wifixcort/moto_location/Readme.md

Moto Location

This sketch use FONA 808 and sparkfun SAMD21 mini to locate through GPS my motorcicle

It use io.adafruit.com platform(MQTT)
