wifixcort/moto_location/motoloc.pdf

UNIVERSIDAD DE COSTA RICA, JULIO 2016 | 1

# Sistema de GPS en Tiempo Real ”MotoLoc”

Ricardo Mena C.

Resumen—Sistema GPS que permite la localizacion de una motocicleta mediante la FONA 808 utilizando el proto ´ | colo MQTT

Index Terms—GPS, FONA808, motoloc

✦

### 1. INTRODUCCION´

E
STE proyecto atiende a una necesidad puntual, la cual es la localizacion mediante GPS de un objeto, en este caso ´ una motocicleta. Esto ofrece cierta seguridad de recuperacion en caso de robo, como ya muchas empresas lo ofrecen, ´
pero ademas que el costo econ ´ | omico de mantenimiento sea ´
mínimo.
Otro inconveniente de los servicios existentes ademas de ´ su elevado costo, es que ofrecen muchos servicios dentro de
un paquete unico, no solamente la localizaci ´ | on. Por lo que ´
no resultaba conveniente adquirir un servicio de terceros.

### 2. COMUNICACION´

Se penso poder tener actualizaciones constantes de la ´
posicion, por lo que se deb ´ | ía contar con una plataforma
con la mayor area de covertura posible dentro del territo- ´ rio nacional, debido a este hecho la primera y mas obvia ´
opcion era la plataforma celular existente, por esta raz ´ | | on se ´
utilizo la ´ | FONA808 dado que es un transmisor celular con
las mismas capacidades que cualquier otro telefono celular. ´ En cuanto a costos independientmente del operador celular, se podían enviar mensajes de texto¹SMS con la informacion, por cada mensaje se eleva el costo, por lo que la ´ mejor opcion deb ´ ía ser utilizar GPRS y de esta forma enviar los mensajes mediante internet; siendo necesario la eleccion´ de un protocolo de comunicacion, as ´ í como una plataforma web para publicar los datos.

### 2.1. Protocolo de Comunicacion´

La seleccion del protocolo de comunicaci ´ | on deb ´ | ía cum-
plir dos aspectos: Verificacion de entrega y tama ´ | | no de ˜
tramos de datos muy pequena, para que se consumiera la ˜ mínima cantidad de datos de GPRS posibles.
Dadas las razones antes mencionandas se selecciono el ´ protocolo MQTT como protocolo de comunicacion. El cual ´ es un protocolo ligero de mesajería, disenado para dispo- ˜ sitivos con restriccion de ancho de banda. Los principios ´ de diseno son para minimizar el ancho de banda de la red ˜ y los requisitos de recursos del dispositivo a la vez que el intento de asegurar la fiabilidad y cierto grado de garantía de entrega [MQTT, 1999].
1. Short Message Service

### 2.2. Plataforma Web

Existen varias plataformas web que implementan 2brokers de MQTT así como tambien puede crearse un servi- ´ cio propio en cualquier servidor. El principal inconveniente de la mayoría de las plataformas era que no disponía de una interfaz web simple para construir y modificar el proyecto. Dada la naturaleza del prototipo se esperanban muchos cambios, por lo que se elijió io.adafruit.com.
Esta plataforma se encuentra actualmente en fase BETA por lo que presenta varias limitaciones tanto de espacio como de confiabilidad, pero lo que se desea verificar es la usabilidad y utilidad del prototipo. Esto se debe a que la plataforma puede cambiarse en cualquier momento, para tener un servicio mas confiable y con menos limitaciones ´ como la cantidad de datos que pueden almacenarse.

### 3. CONSTITUCION´

Para realizar el sistema fue necesario:

Microcontrolador: SAMD21 de sparkfun Transmisor GPRS/GPS: FONA 808
StepDown: Etapa de reduccion de tensi ´ | on´
Sensor de Vibracion: Aceler ´ | ometro ADXL335 ´
Cables de silicon´

### 3.1. Microcontrolador

Para este diseno se utiliz ˜ | o el sparkfun SAMD21 deve- ´
lopment board mini, ya que su tamano f ˜ | ísico y capacidades
de espacio en memoria eran optimos, tanto para albergar el ´ proyecto como para servir de ”prevista”, en caso de futuras mejoras. Este pequeno microcontrolador es un chip ARM de ˜ 12bit lo que permite un mayor muestreo y por consecuencia mayor presicion. ´
Este alberga todos los algorítmos logicos del sistema por ´ lo que sus funciones son las de mantener la conectividad con la red celular y en caso de una perdida realizar la reco- ´ nexion, si esto no resultase efectivo debe hacer un reinicio ´ automatico de la FONA808. Realizar mediciones del GPS, ´ nivel de batería y vibraciones ocurridas.
Anteriormente al SAMD21 se utilizo un ”Trinket pro”, ´ el cual es un AVR de 8 bits, el espacio de este pequenõ
2. Servidor intermediario que publica los mensajes recibidos microcontrolador apenas permitía gestionar el control de la
FONA808 y las lecturas de GPS. Por esta razon se pens ´ | o en ´
una mejor plataforma de hardware como el SAMD21 ya que era conveniente crear un diseno que permitiera posteriores ˜ modificaciones, como las que se realizaron algun tiempo ´ despues de a ´ nadir un sensor para medir vibraciones, entre ˜ otros cambios planeados.

### 3.2. Transmisor GPRS/GPS

Para este prototipo se eligio la FONA808 de Adafruit ´
por una razon coincidente con la elecci ´ | on del SAMD21, su ´
tamano como primer punto. ˜
Aunque esta tarjeta es solamente transmisor en las bandas celulares y para que sea funcional requiere de un microcontrolador, tiene como característica la incorporacion´
de un GPS, ademas de un cargador de bater ´ | ía. Por lo que
solucionaba el evitar el gasto en un transmisor celular y por aparte un GPS, que no solo incluye un costo economico en ´
la ecuacion, sino que tambi ´ | en beneficia en una reducci ´ | on de ´
espacio.

### 3.3. StepDown

El SAMD21 es un microcontrolador de tecnología CMOS
por lo que su tension de operaci ´ | on es de tan solo 3.3v, ´
aunque como es una placa de desarrollo tiene un regulador de 5v para que pueda conectarse sin problemas a una computadora para programarlo, aun as ´ í el sistema electrico ´ de las motocicletas trabajan a una tension de 12v por lo que ´ no puede utilizarse de forma directa para el proyecto.
Por esta razon es necesario una etapa de reducci ´ | on de ´
tension para que la motocicleta alimente de forma constante ´ el proyecto y cargue una batería de respaldo de 2200mA con
una duracion aproximada de 3 d ´ | ías con carga, en caso de
fallo o desconeccion malintencionada de la bater ´ | ía principal.

### 3.4. Sensor de vibracion´

Al prototipo se le anadi ˜ | o un sensor de vibraci ´ | on o m ´ | as´
bien un acelerometro utilizado como sensor de vibraci ´ | on´
luego de haber tenido un percanse mientras se dejo la ´ motocicleta en un parqueo, el cual no informo debidamente ´ tal hecho.
Se utilizo un aceler ´ | ometro ADXL335 el cual es un sensor ´
analogico [ ´ | IteadStudio, 2011]; solo se lee uno de los tres
canales ya que cualquier vibracion debe afectar en los tres ´ ejes.
Las primeras pruebas para utilzar el acelerometro como ´
un sensor de vibracion fueron simplmente por inspecci ´ | on. ´
Imprimir en el puerto serial de Arduino IDE los datos en crudo del sensor como se aprecia en la figura 1;
Se aislo una de las perturbaciones para facilitar la inspec- ´
cion de la se ´ | nal en cuesti ˜ | on como se aprecia en la figura ´ | 2.
Durante el proceso de investifgacion se not ´ | o que al golpear ´
la motocicleta los datos por razon obvia iban a variar en un ´
lapso muy pequeno de tiempo con una dispersi ˜ | on de los ´
datos bastatante pronunciada, esto dio paso a pensar inmediatamente en la desviacion est ´ andar de un promedio de ´ datos. Una forma muy simple de poder medir la vibracion´ y tener cierta idea de su intensidad.

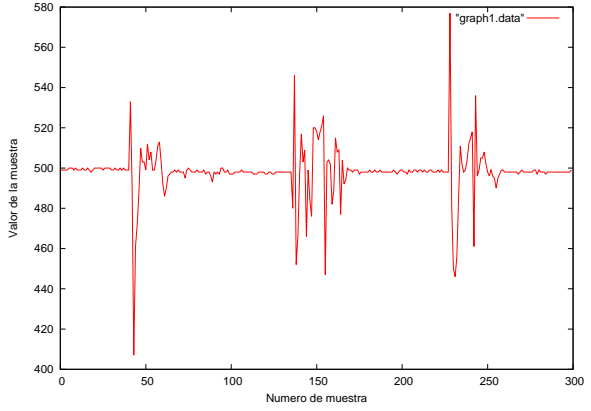
[picture p1: figure]
Valor de la muestra; Numero de muestra; "graph1.data"

Figura 1. Datos del sensor ADXL335

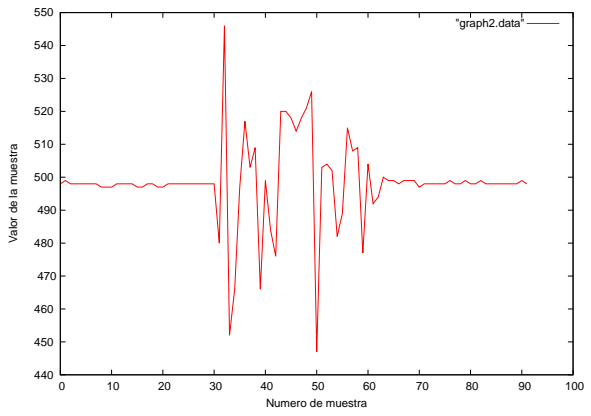
[picture p2: figure]
Valor de la muestra; Numero de muestra; "graph2.data"

Figura 2. Vibracion aislada del sensor ADXL335 ´

La razon de medir la dispersi ´ | on de los datos y no vibra- ´
ciones fuertes o deviles se fundamente en que solo se desean medir golpes repentinos, por lo que una vibracion fuerte ´ mientras se conduce no debe generar alertas, principlamente se esperan alertas por colisiones. Un caso de ejemplo rapido ´ sería que uno se encuentre estacionado y alguien quiera robarse la motocicleta o la golpee por accidente.
Como puede verse de la la figura 3 es mucho mas f ´ acil ´ reconocer los golpes recibidos y mucho mas simples de ´ procesar.

### 4. CONSTRUCCION´

En principio se realizaron las coneciones con cables hembra-hembra de prototipado rapido y todo se guardo ´ dentro de una bolsa plastica. Este prototipo simple permi- ´ tiría comprobar la conectividad a la red celular mientras el motoloc se encontraba dentro del compartimento de la motocicleta, luego de comprobada la conectividad durante varios viajes cortos, se utilizo una caja impresa en ´

3 PLA que
se tenía a mano que puede verse en figura 4(No fue creada para este proyecto, solamente sería para guardar el proyecto temporalmente).
Los pasos siguientes fueron armar el prototipo de una
manera mas firme con cables de silic ´ | on ya que su flexibili- ´
3. Acido polil ´ | actico ´

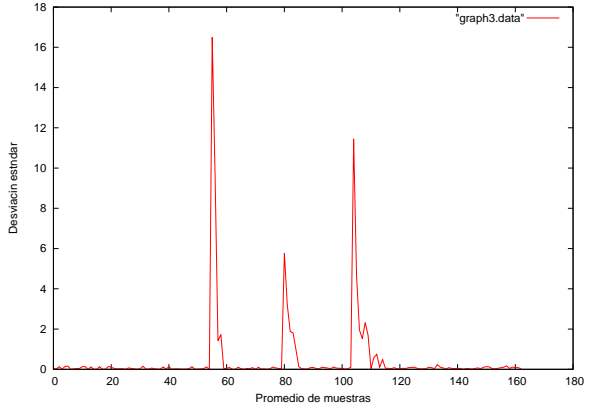
[picture p3: figure]
Desviacin estndar; Promedio de muestras; "graph3.data"

Figura 3. Desviacion est ´ | andar del las mediciones realizadas ´
dad permite un mejor producto; se creo una caja mucho m ´ | as´
pequena para guardar el proyecto, as ˜ | í se reduciría el espacio
que este ocupaba.
Luego de varios meses de prueba se anadi ˜ | o el aceler ´ | ome- ´
tro, para medir vibraciones en la motocicleta.

### 4.1. Conexion con Adafruit ´

Adafruit proporciona excelentes recursos [Ada, 2016] juntos con sus librerías por lo que la conexion con su sitio ´ no fue gran problema.
En un inicio el unico problema era que la plataforma ´ se caía cada cierto tiempo, por lo que se presentaba cierta perdida de informacion. ´

### 4.2. Reinicio

Se precentaron varios contratiempos para garantizar las reconexiones y reinicios de sistema ya que debían de verificarse varios parametros como: ´

Conexion con la red celular ´
Estado del GPRS
Conexion con adafruit ´
Verificacion de entrega ´

En todos los casos debe verificarse antes de intentar enviar cada mensaje y en caso de cierta cantidad de fallos
reiniciar unicamente la ´ | FONA808. Solo por casos muy es-
pecíficos al inicio de la FONA808 se reinicia todo el sistema, como por ejemplo que no este teniendo ninguna respuesta ´ al iniciar.
En un principio el orden en que estos debían revisarse no eran muy claros o se reiniciaba todo el sistema sin ser realmente necesario, por lo que paso un largo proceso de ´ depuracion para que los reinicios fueran realmente justifica- ´ dos. Esto es una parte crítica del sistema ya que cada reinicio representa al menos 30 segundos perdidos que se requieren para iniciar la FONA808 de manera correcta.

### 5. CONCLUCION´

Se logro construir un sistema de ´ | GPS con conexion a in- ´
ternet que funciona dentro de todo el territorio nacional, que
por su comodo tama ´ | no puede incrustarse en espacios muy ˜

reducidos como en una motocicleta y puede monitirearse desde cualquier parte del mundo; el protocolo utilizado optimiza el consumo de datos, gastando un aproximado de 2000 colones cada dos meses en una línea prepago contrario a otros sistemas que pueden cobrar hasta un dolar por día para ofrecer sus servicios.
El costo total de los componentes es de aproximadamente $123 y todos los componentes utilizados se consiguieron
4
localmente lo que sopone un gran beneficio de ahorro. Logrando de este modo la meta del proyecto de obtener un servicio eficiente y de bajo costo de monitorio GPS.
Uno de los mayores valores agregados de este proyecto es compartir el codigo para que otras personas puedan ´ adaptarlo a sus necesidades. Por lo que todo el codigo ´ referente al proyecto se encuentra en 5 github.

### 6. ANEXOS

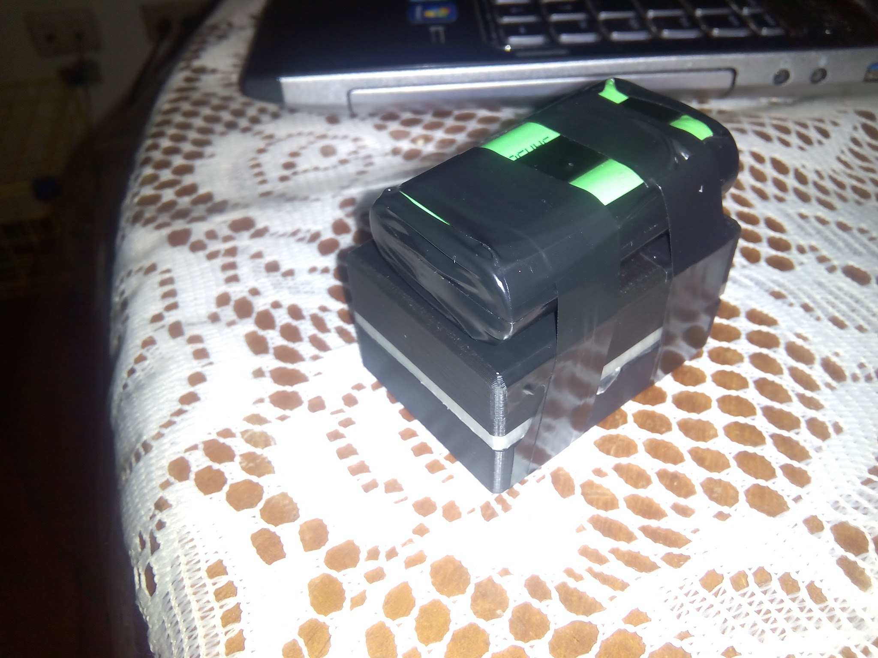
[picture p4: figure]

Figura 4. Prototipo Rapido ´

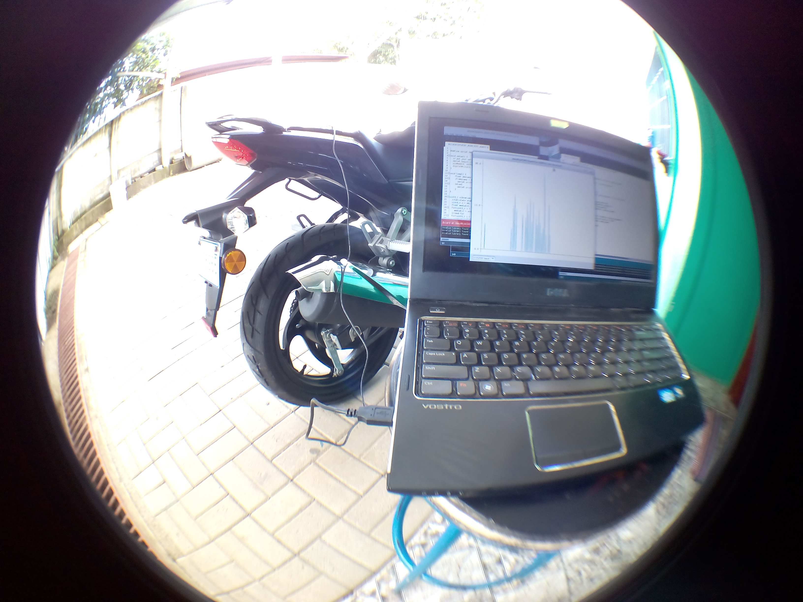
[picture p5: figure]

Figura 5. Medicion de Desviaci ´ | on Est ´ | andar ´
4. Todos los componentes fueron adquiridos en crcibernetica.com
5. https://github.com/wifixcort/moto location (https://github.com/wifixcort/moto_location)

UNIVERSIDAD DE COSTA RICA, JULIO 2016

REFERENCIAS

[Ada, 2016] Ada, L. (2016). Fona 808 overview.
[IteadStudio, 2011] IteadStudio (2011). ADXL335 Overview. IteadStudio.
[MQTT, 1999] MQTT (1999). Frequently asked questions.
