wifixcort/moto_location/FreeCAD/step_down_case.fcstd

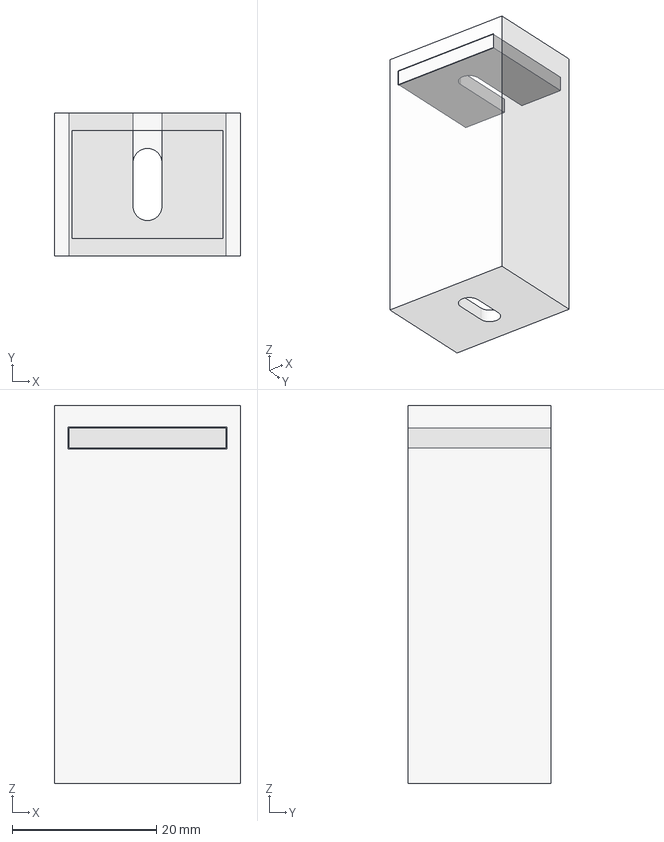
[picture p6: CAD file, 2016-05-09]
FreeCAD/step_down_case.fcstd
25.8 x 19.8 x 52.4 mm
