wifixcort/moto_location/FreeCAD/fona_gps_enclosure.fcstd

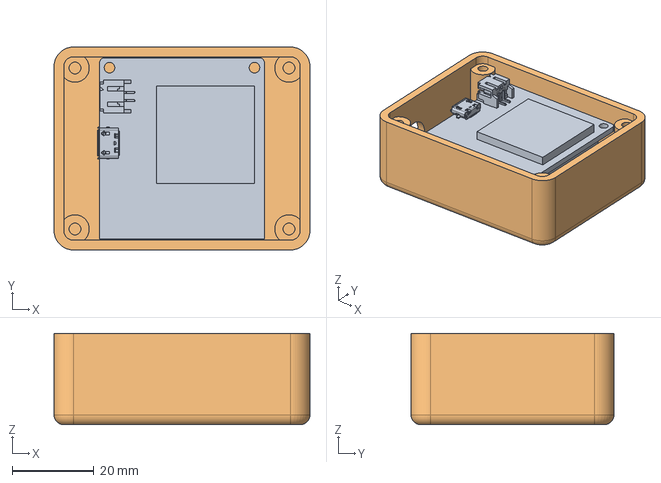
[picture p7: CAD file, 2016-05-09]
FreeCAD/fona_gps_enclosure.fcstd
62.8 x 49.8 x 22.4 mm
SAMD&FONA
enclosure_v1
