wifixcort/moto_location/(notices)

Notices in the files:
src/moto_location.ino:
Public License as published by the Free Software
Public License along with this program.
